loansindi/ps1_noise/parts_list.txt

You need one of each of the following parts per noisemaker

Digikey part numbers:

445-2525-3-ND - Piezo buzzer
ATTINY45-20PU-ND - ATTiny45 DIP-8
952-1735-1-ND - Battery holder
P189-ND - CR2032 battery
PDV-P8103-ND - Photocell
RNF18FTD10K0CT-ND - 10k resistor, through hole

---

Each noisemaker will also require:

2x M2 screws, long enough to reach through your board material
2x M2 nuts

---

I used 1/8" acrylic for the boards. Any reasonably stiff material will work. I found that transparent colors of acrylic
work *much* better than opaque - being able to see the board art from both sides is very useful.
