loansindi/ps1_noise/laser_cut_board_batch.pdf

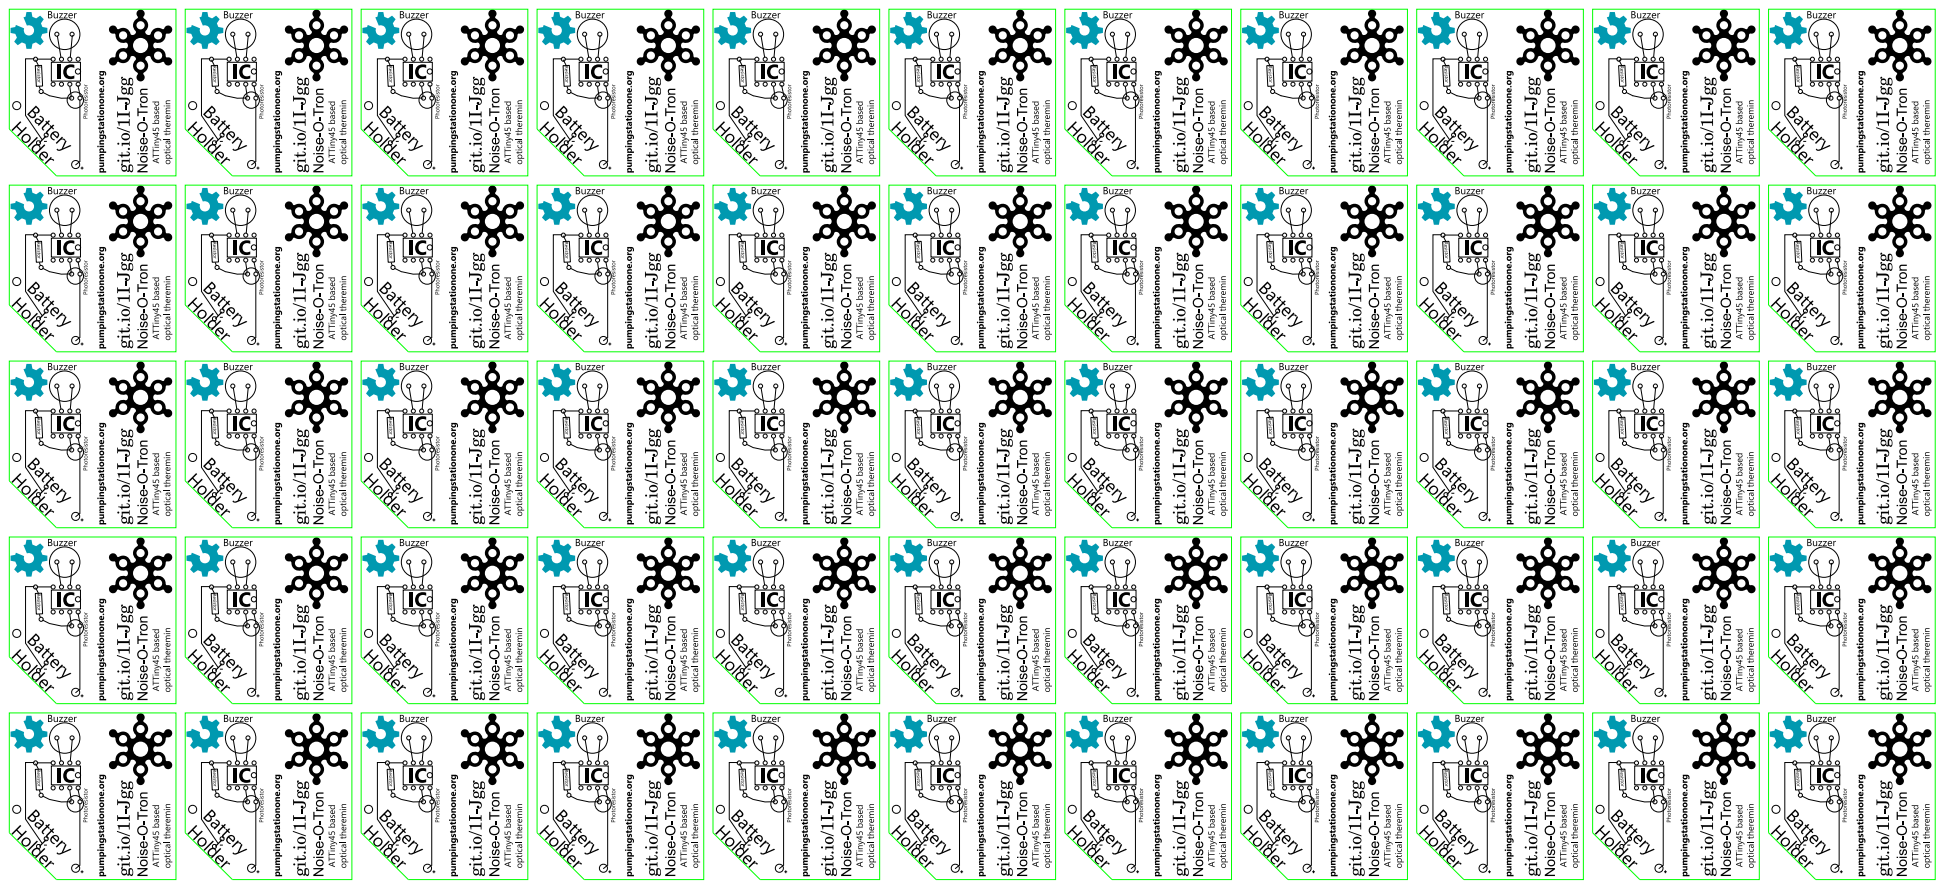
[picture p3: page 1]
