loansindi/ps1_noise/(threads)

Thread 3 (2014-08-06):

Limited pitch range

loansindi, 2014-08-06:
I've had little time to troubleshoot this, but the existing code doesn't do a great job of generating a large variance in pitch.

loansindi, 2016-05-06:
Fixed by #12

Closed 2016-05-06.

Thread 10 (2014-09-22):

Layout change - battery holder conflicts with resistor

loansindi, 2014-09-22:
09:11 < `justin> btw, i have a new issue on the board layout
09:12 < `justin> the resistor is too close to the battery holder
09:12 < `justin> we had a bunch that "didn't work" on saturday because the ADC side of the resistor was touching it
09:12 -!- bry [~blabla@38.124.31.10] has joined #pumpingstationone
09:13 < `justin> and i didn't realize that was the issue until someone early sunday morning asked me if that was supposed to be touching
09:13 < `justin> so from then on, when i was checking peoples circuits, i had to grab a small screwdriver and push that lead away from the battery holder
09:13 < `justin> sometimes people screwed it down on top of the lead and i had to loosen a screw to get it away

loansindi, 2016-05-06:
fixed by #12

Closed 2016-05-06.
