loansindi/ps1_noise/(commit log)

2014-04-13 Initial commit
    Vector file for board - to be laser cut
2014-04-14 New revision of board
    Add text and logo, add cutout. Board is 2"x2"
    Holes for battery holder need to be larger
2014-04-22 Add board art.
2014-04-22 Fix stroke weight on battery holder mounting holes
2014-04-30 Board layout revision
2014-05-01 'final' revision of board. remove QR code because it sucks.
2014-07-25 board updates. clean up lines, move text, add link
2014-07-25 add bitmap preview of board art
2014-07-30 add 11-count pdf for laser cutting
2014-07-31 add thirty board pdf, fix counting error in ten board pdf
2014-07-31 update readme with info on cutting boards
2014-07-31 add image of board
2014-08-01 update BOM
2014-08-11 update board art to make URL legible
2014-08-12 update rendering of board art
2014-08-12 newer image of completed board
2014-08-13 screw length
2014-08-14 add log to analogRead - rework beep()
    [noisemaker_sketch.ino]
2014-08-22 update 'assembly'
2014-08-27 slightly cheaper socket
2014-09-12 update range of noise
    [noisemaker_sketch.ino]
2014-09-14 Add paths-only version of board art to alleviate fonts issues
2015-03-25 cheaper DIP socket
2015-07-13 update resistor placement
2016-05-06 Cuts off the corner of the board.
    For easier battery removal and such.
2016-05-06 Adds batch production files.
    Adds some files for conveniently cutting out production run of boards from
    a 24x12 piece of material.
2016-05-06 Makes the pitch range a little wider.
